VeresDenisa/Licenta/images/Design/LEDMANAGER.png

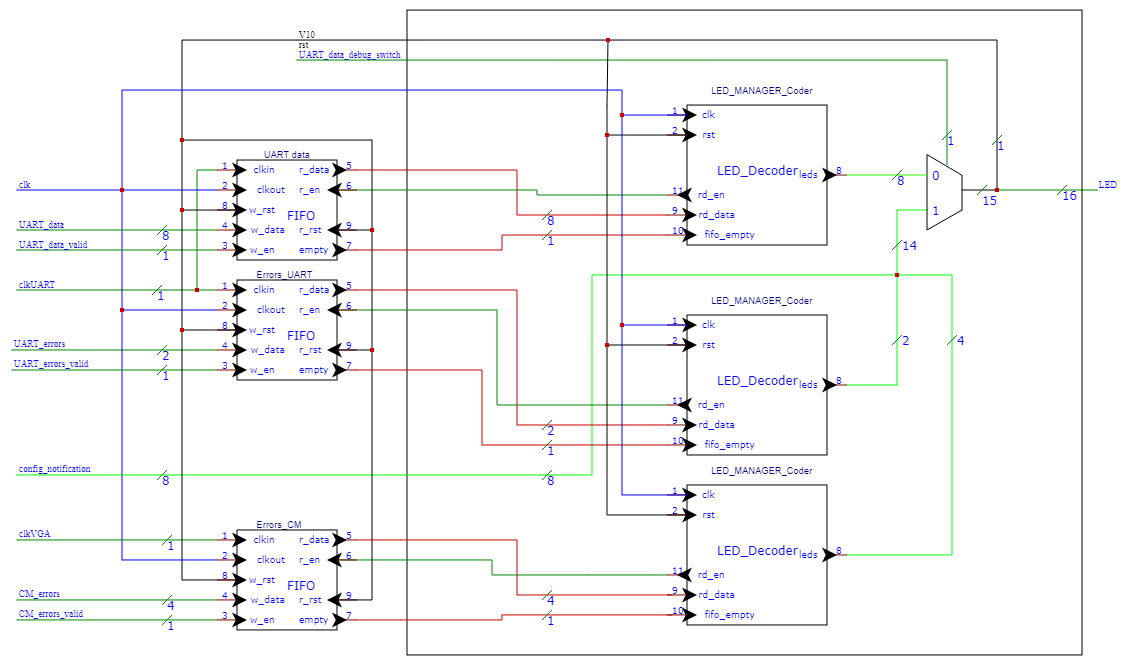
images/Design/LEDMANAGER.png
