VeresDenisa/Licenta/images/Design/project_final.png

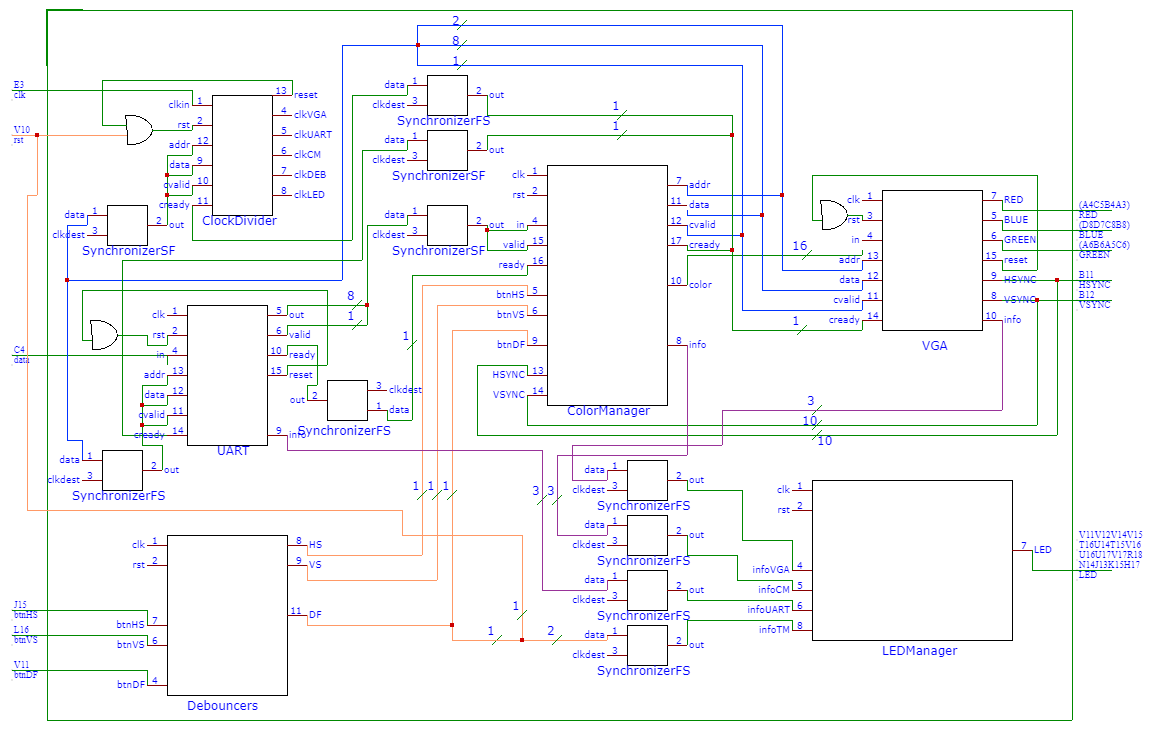
images/Design/project_final.png
