VeresDenisa/Licenta/source/simulation/coverage/coverage_CM_test.txt

COVERGROUP COVERAGE:
-----------------------------------------------------------------------------------------------
Covergroup                                             Metric       Goal    Status               
                                                                                              
-----------------------------------------------------------------------------------------------
 TYPE /CM_coverage_pack/CM_input_covergroup           100.00%        100    Covered              
    covered/total bins:                                    15         15                      
    missing/total bins:                                     0         15                      
    % Hit:                                            100.00%        100                      
    type_option.weight=1
    type_option.goal=100
    type_option.comment=
    type_option.strobe=0
    type_option.merge_instances=auto(0)
    Coverpoint CM_input_covergroup::HSync_cvp         100.00%        100    Covered              
        covered/total bins:                                 2          2                      
        missing/total bins:                                 0          2                      
        % Hit:                                        100.00%        100                      
        type_option.weight=1
        type_option.goal=100
        type_option.comment=
    Coverpoint CM_input_covergroup::VSync_cvp         100.00%        100    Covered              
        covered/total bins:                                 2          2                      
        missing/total bins:                                 0          2                      
        % Hit:                                        100.00%        100                      
        type_option.weight=1
        type_option.goal=100
        type_option.comment=
    Coverpoint CM_input_covergroup::Vertical_Split_cvp 
                                                      100.00%        100    Covered              
        covered/total bins:                                 2          2                      
        missing/total bins:                                 0          2                      
        % Hit:                                        100.00%        100                      
        type_option.weight=1
        type_option.goal=100
        type_option.comment=
    Coverpoint CM_input_covergroup::Horizontal_Split_cvp 
                                                      100.00%        100    Covered              
        covered/total bins:                                 2          2                      
        missing/total bins:                                 0          2                      
        % Hit:                                        100.00%        100                      
        type_option.weight=1
        type_option.goal=100
        type_option.comment=
    Coverpoint CM_input_covergroup::Empty_cvp         100.00%        100    Covered              
        covered/total bins:                                 2          2                      
        missing/total bins:                                 0          2                      
        % Hit:                                        100.00%        100                      
        type_option.weight=1
        type_option.goal=100
        type_option.comment=
    Coverpoint CM_input_covergroup::VGA_debug_cvp     100.00%        100    Covered              
        covered/total bins:                                 2          2                      
        missing/total bins:                                 0          2                      
        % Hit:                                        100.00%        100                      
        type_option.weight=1
        type_option.goal=100
        type_option.comment=
    Coverpoint CM_input_covergroup::RXD_Data_cvp      100.00%        100    Covered              
        covered/total bins:                                 3          3                      
        missing/total bins:                                 0          3                      
        % Hit:                                        100.00%        100                      
        type_option.weight=1
        type_option.goal=100
        type_option.comment=
 Covergroup instance \/CM_coverage_pack::CM_coverage::CM_input_cvg  
                                                      100.00%        100    Covered              
    covered/total bins:                                    15         15                      
    missing/total bins:                                     0         15                      
    % Hit:                                            100.00%        100                      
    option.name=\/CM_coverage_pack::CM_coverage::CM_input_cvg 
    option.weight=1
    option.goal=100
    option.comment=
    option.at_least=1
    option.auto_bin_max=64
    option.cross_num_print_missing=0
    option.detect_overlap=0
    option.per_instance=0
    option.get_inst_coverage=0
    Coverpoint HSync_cvp                              100.00%        100    Covered              
        covered/total bins:                                 2          2                      
        missing/total bins:                                 0          2                      
        % Hit:                                        100.00%        100                      
        option.weight=1
        option.goal=100
        option.comment=
        option.at_least=1
        option.auto_bin_max=64
        option.detect_overlap=0
        bin value_binary[0]                                59          1    Covered              
        bin value_binary[1]                                49          1    Covered              
    Coverpoint VSync_cvp                              100.00%        100    Covered              
        covered/total bins:                                 2          2                      
        missing/total bins:                                 0          2                      
        % Hit:                                        100.00%        100                      
        option.weight=1
        option.goal=100
        option.comment=
        option.at_least=1
        option.auto_bin_max=64
        option.detect_overlap=0
        bin value_binary[0]                                65          1    Covered              
        bin value_binary[1]                                43          1    Covered              
    Coverpoint Vertical_Split_cvp                     100.00%        100    Covered              
        covered/total bins:                                 2          2                      
        missing/total bins:                                 0          2                      
        % Hit:                                        100.00%        100                      
        option.weight=1
        option.goal=100
        option.comment=
        option.at_least=1
        option.auto_bin_max=64
        option.detect_overlap=0
        bin value_binary[0]                                59          1    Covered              
        bin value_binary[1]                                49          1    Covered              
    Coverpoint Horizontal_Split_cvp                   100.00%        100    Covered              
        covered/total bins:                                 2          2                      
        missing/total bins:                                 0          2                      
        % Hit:                                        100.00%        100                      
        option.weight=1
        option.goal=100
        option.comment=
        option.at_least=1
        option.auto_bin_max=64
        option.detect_overlap=0
        bin value_binary[0]                                59          1    Covered              
        bin value_binary[1]                                49          1    Covered              
    Coverpoint Empty_cvp                              100.00%        100    Covered              
        covered/total bins:                                 2          2                      
        missing/total bins:                                 0          2                      
        % Hit:                                        100.00%        100                      
        option.weight=1
        option.goal=100
        option.comment=
        option.at_least=1
        option.auto_bin_max=64
        option.detect_overlap=0
        bin value_binary[0]                                60          1    Covered              
        bin value_binary[1]                                48          1    Covered              
    Coverpoint VGA_debug_cvp                          100.00%        100    Covered              
        covered/total bins:                                 2          2                      
        missing/total bins:                                 0          2                      
        % Hit:                                        100.00%        100                      
        option.weight=1
        option.goal=100
        option.comment=
        option.at_least=1
        option.auto_bin_max=64
        option.detect_overlap=0
        bin value_binary[0]                                63          1    Covered              
        bin value_binary[1]                                45          1    Covered              
    Coverpoint RXD_Data_cvp                           100.00%        100    Covered              
        covered/total bins:                                 3          3                      
        missing/total bins:                                 0          3                      
        % Hit:                                        100.00%        100                      
        option.weight=1
        option.goal=100
        option.comment=
        option.at_least=1
        option.auto_bin_max=64
        option.detect_overlap=0
        bin inter_values[0]                                42          1    Covered              
        bin inter_values[1]                                31          1    Covered              
        bin inter_values[2]                                35          1    Covered              
 TYPE /CM_coverage_pack/CM_output_covergroup           76.56%        100    Uncovered            
    covered/total bins:                                     9         54                      
    missing/total bins:                                    45         54                      
    % Hit:                                             16.66%        100                      
    type_option.weight=1
    type_option.goal=100
    type_option.comment=
    type_option.strobe=0
    type_option.merge_instances=auto(0)
    Coverpoint CM_output_covergroup::Config_Notification_Valid_cvp 
                                                      100.00%        100    Covered              
        covered/total bins:                                 2          2                      
        missing/total bins:                                 0          2                      
        % Hit:                                        100.00%        100                      
        type_option.weight=1
        type_option.goal=100
        type_option.comment=
    Coverpoint CM_output_covergroup::VGA_Notification_Valid_cvp 
                                                      100.00%        100    Covered              
        covered/total bins:                                 2          2                      
        missing/total bins:                                 0          2                      
        % Hit:                                        100.00%        100                      
        type_option.weight=1
        type_option.goal=100
        type_option.comment=
    Coverpoint CM_output_covergroup::Error_Valid_cvp 
                                                      100.00%        100    Covered              
        covered/total bins:                                 2          2                      
        missing/total bins:                                 0          2                      
        % Hit:                                        100.00%        100                      
        type_option.weight=1
        type_option.goal=100
        type_option.comment=
    Coverpoint CM_output_covergroup::Data_VGA_cvp       6.25%        100    Uncovered            
        covered/total bins:                                 3         48                      
        missing/total bins:                                45         48                      
        % Hit:                                          6.25%        100                      
        type_option.weight=1
        type_option.goal=100
        type_option.comment=
 Covergroup instance \/CM_coverage_pack::CM_coverage::CM_output_cvg  
                                                       76.56%        100    Uncovered            
    covered/total bins:                                     9         54                      
    missing/total bins:                                    45         54                      
    % Hit:                                             16.66%        100                      
    option.name=\/CM_coverage_pack::CM_coverage::CM_output_cvg 
    option.weight=1
    option.goal=100
    option.comment=
    option.at_least=1
    option.auto_bin_max=64
    option.cross_num_print_missing=0
    option.detect_overlap=0
    option.per_instance=0
    option.get_inst_coverage=0
    Coverpoint Config_Notification_Valid_cvp          100.00%        100    Covered              
        covered/total bins:                                 2          2                      
        missing/total bins:                                 0          2                      
        % Hit:                                        100.00%        100                      
        option.weight=1
        option.goal=100
        option.comment=
        option.at_least=1
        option.auto_bin_max=64
        option.detect_overlap=0
        bin value_binary[0]                               106          1    Covered              
        bin value_binary[1]                                 6          1    Covered              
    Coverpoint VGA_Notification_Valid_cvp             100.00%        100    Covered              
        covered/total bins:                                 2          2                      
        missing/total bins:                                 0          2                      
        % Hit:                                        100.00%        100                      
        option.weight=1
        option.goal=100
        option.comment=
        option.at_least=1
        option.auto_bin_max=64
        option.detect_overlap=0
        bin value_binary[0]                                71          1    Covered              
        bin value_binary[1]                                41          1    Covered              
    Coverpoint Error_Valid_cvp                        100.00%        100    Covered              
        covered/total bins:                                 2          2                      
        missing/total bins:                                 0          2                      
        % Hit:                                        100.00%        100                      
        option.weight=1
        option.goal=100
        option.comment=
        option.at_least=1
        option.auto_bin_max=64
        option.detect_overlap=0
        bin value_binary[0]                               102          1    Covered              
        bin value_binary[1]                                10          1    Covered              
    Coverpoint Data_VGA_cvp                             6.25%        100    Uncovered            
        covered/total bins:                                 3         48                      
        missing/total bins:                                45         48                      
        % Hit:                                          6.25%        100                      
        option.weight=1
        option.goal=100
        option.comment=
        option.at_least=1
        option.auto_bin_max=64
        option.detect_overlap=0
        bin values05[0]                                   112          1    Covered              
        bin values05[1]                                     0          1    ZERO                 
        bin values05[2]                                     0          1    ZERO                 
        bin values05[3]                                     0          1    ZERO                 
        bin values05[4]                                     0          1    ZERO                 
        bin values05[5]                                     0          1    ZERO                 
        bin values05[6]                                     0          1    ZERO                 
        bin values05[7]                                     0          1    ZERO                 
        bin values0A[0]                                   112          1    Covered              
        bin values0A[1]                                     0          1    ZERO                 
        bin values0A[2]                                     0          1    ZERO                 
        bin values0A[3]                                     0          1    ZERO                 
        bin values0A[4]                                     0          1    ZERO                 
        bin values0A[5]                                     0          1    ZERO                 
        bin values0A[6]                                     0          1    ZERO                 
        bin values0A[7]                                     0          1    ZERO                 
        bin values0F[0]                                   112          1    Covered              
        bin values0F[1]                                     0          1    ZERO                 
        bin values0F[2]                                     0          1    ZERO                 
        bin values0F[3]                                     0          1    ZERO                 
        bin values0F[4]                                     0          1    ZERO                 
        bin values0F[5]                                     0          1    ZERO                 
        bin values0F[6]                                     0          1    ZERO                 
        bin values0F[7]                                     0          1    ZERO                 
        bin values5A[0]                                     0          1    ZERO                 
        bin values5A[1]                                     0          1    ZERO                 
        bin values5A[2]                                     0          1    ZERO                 
        bin values5A[3]                                     0          1    ZERO                 
        bin values5A[4]                                     0          1    ZERO                 
        bin values5A[5]                                     0          1    ZERO                 
        bin values5A[6]                                     0          1    ZERO                 
        bin values5A[7]                                     0          1    ZERO                 
        bin values5F[0]                                     0          1    ZERO                 
        bin values5F[1]                                     0          1    ZERO                 
        bin values5F[2]                                     0          1    ZERO                 
        bin values5F[3]                                     0          1    ZERO                 
        bin values5F[4]                                     0          1    ZERO                 
        bin values5F[5]                                     0          1    ZERO                 
        bin values5F[6]                                     0          1    ZERO                 
        bin values5F[7]                                     0          1    ZERO                 
        bin valuesAF[0]                                     0          1    ZERO                 
        bin valuesAF[1]                                     0          1    ZERO                 
        bin valuesAF[2]                                     0          1    ZERO                 
        bin valuesAF[3]                                     0          1    ZERO                 
        bin valuesAF[4]                                     0          1    ZERO                 
        bin valuesAF[5]                                     0          1    ZERO                 
        bin valuesAF[6]                                     0          1    ZERO                 
        bin valuesAF[7]                                     0          1    ZERO                 

TOTAL COVERGROUP COVERAGE: 88.28%  COVERGROUP TYPES: 2
