VeresDenisa/Licenta/source/simulation/coverage/coverage_LM_test.txt

COVERGROUP COVERAGE:
-----------------------------------------------------------------------------------------------
Covergroup                                             Metric       Goal    Status               
                                                                                              
-----------------------------------------------------------------------------------------------
 TYPE /LM_coverage_pack/CM_output_covergroup          100.00%        100    Covered              
    covered/total bins:                                     6         54                      
    missing/total bins:                                    48         54                      
    % Hit:                                             11.11%        100                      
    type_option.weight=1
    type_option.goal=100
    type_option.comment=
    type_option.strobe=0
    type_option.merge_instances=auto(0)
    Coverpoint CM_output_covergroup::Config_Notification_Valid_cvp 
                                                      100.00%        100    Covered              
        covered/total bins:                                 2          2                      
        missing/total bins:                                 0          2                      
        % Hit:                                        100.00%        100                      
        type_option.weight=1
        type_option.goal=100
        type_option.comment=
    Coverpoint CM_output_covergroup::VGA_Notification_Valid_cvp 
                                                      100.00%        100    Covered              
        covered/total bins:                                 2          2                      
        missing/total bins:                                 0          2                      
        % Hit:                                        100.00%        100                      
        type_option.weight=1
        type_option.goal=100
        type_option.comment=
    Coverpoint CM_output_covergroup::Error_Valid_cvp 
                                                      100.00%        100    Covered              
        covered/total bins:                                 2          2                      
        missing/total bins:                                 0          2                      
        % Hit:                                        100.00%        100                      
        type_option.weight=1
        type_option.goal=100
        type_option.comment=
    Coverpoint CM_output_covergroup::Data_VGA_cvp       0.00%        100    ZERO                 
        covered/total bins:                                 0          0                      
        missing/total bins:                                 0          0                      
        % Hit:                                        100.00%        100                      
        type_option.weight=1
        type_option.goal=100
        type_option.comment=
 Covergroup instance \/LM_coverage_pack::LM_coverage::CM_output_cvg  
                                                      100.00%        100    Covered              
    covered/total bins:                                     6         54                      
    missing/total bins:                                    48         54                      
    % Hit:                                             11.11%        100                      
    option.name=\/LM_coverage_pack::LM_coverage::CM_output_cvg 
    option.weight=1
    option.goal=100
    option.comment=
    option.at_least=1
    option.auto_bin_max=64
    option.cross_num_print_missing=0
    option.detect_overlap=0
    option.per_instance=0
    option.get_inst_coverage=0
    Coverpoint Config_Notification_Valid_cvp          100.00%        100    Covered              
        covered/total bins:                                 2          2                      
        missing/total bins:                                 0          2                      
        % Hit:                                        100.00%        100                      
        option.weight=1
        option.goal=100
        option.comment=
        option.at_least=1
        option.auto_bin_max=64
        option.detect_overlap=0
        bin value_binary[0]                                82          1    Covered              
        bin value_binary[1]                                66          1    Covered              
    Coverpoint VGA_Notification_Valid_cvp             100.00%        100    Covered              
        covered/total bins:                                 2          2                      
        missing/total bins:                                 0          2                      
        % Hit:                                        100.00%        100                      
        option.weight=1
        option.goal=100
        option.comment=
        option.at_least=1
        option.auto_bin_max=64
        option.detect_overlap=0
        bin value_binary[0]                                73          1    Covered              
        bin value_binary[1]                                75          1    Covered              
    Coverpoint Error_Valid_cvp                        100.00%        100    Covered              
        covered/total bins:                                 2          2                      
        missing/total bins:                                 0          2                      
        % Hit:                                        100.00%        100                      
        option.weight=1
        option.goal=100
        option.comment=
        option.at_least=1
        option.auto_bin_max=64
        option.detect_overlap=0
        bin value_binary[0]                                68          1    Covered              
        bin value_binary[1]                                80          1    Covered              
    Coverpoint Data_VGA_cvp [1]                         0.00%        100    ZERO                 
        covered/total bins:                                 0         48                      
        missing/total bins:                                48         48                      
        % Hit:                                          0.00%        100                      
        option.weight=0
        option.goal=100
        option.comment=
        option.at_least=1
        option.auto_bin_max=64
        option.detect_overlap=0
        bin values05[0]                                     0          1    ZERO                 
        bin values05[1]                                     0          1    ZERO                 
        bin values05[2]                                     0          1    ZERO                 
        bin values05[3]                                     0          1    ZERO                 
        bin values05[4]                                     0          1    ZERO                 
        bin values05[5]                                     0          1    ZERO                 
        bin values05[6]                                     0          1    ZERO                 
        bin values05[7]                                     0          1    ZERO                 
        bin values0A[0]                                     0          1    ZERO                 
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
    Coverpoint LM_covergroup::leds6_cvp               100.00%        100    Covered              
        covered/total bins:                                 2          2                      
        missing/total bins:                                 0          2                      
        % Hit:                                        100.00%        100                      
        type_option.weight=1
        type_option.goal=100
        type_option.comment=
    Coverpoint LM_covergroup::leds7_cvp               100.00%        100    Covered              
        covered/total bins:                                 2          2                      
        missing/total bins:                                 0          2                      
        % Hit:                                        100.00%        100                      
        type_option.weight=1
        type_option.goal=100
        type_option.comment=
 Covergroup instance \/LM_coverage_pack::LM_coverage::LM_cvg  
                                                      100.00%        100    Covered              
    covered/total bins:                                    16         16                      
    missing/total bins:                                     0         16                      
    % Hit:                                            100.00%        100                      
    option.name=\/LM_coverage_pack::LM_coverage::LM_cvg 
    option.weight=1
    option.goal=100
    option.comment=
    option.at_least=1
    option.auto_bin_max=64
    option.cross_num_print_missing=0
    option.detect_overlap=0
    option.per_instance=0
    option.get_inst_coverage=0
    Coverpoint leds0_cvp                              100.00%        100    Covered              
        covered/total bins:                                 2          2                      
        missing/total bins:                                 0          2                      
        % Hit:                                        100.00%        100                      
        option.weight=1
        option.goal=100
        option.comment=
        option.at_least=1
        option.auto_bin_max=64
        option.detect_overlap=0
        bin value_binary[0]                                87          1    Covered              
        bin value_binary[1]                                41          1    Covered              
    Coverpoint leds1_cvp                              100.00%        100    Covered              
        covered/total bins:                                 2          2                      
        missing/total bins:                                 0          2                      
        % Hit:                                        100.00%        100                      
        option.weight=1
        option.goal=100
        option.comment=
        option.at_least=1
        option.auto_bin_max=64
        option.detect_overlap=0
        bin value_binary[0]                                87          1    Covered              
        bin value_binary[1]                                41          1    Covered              
    Coverpoint leds2_cvp                              100.00%        100    Covered              
        covered/total bins:                                 2          2                      
        missing/total bins:                                 0          2                      
        % Hit:                                        100.00%        100                      
        option.weight=1
        option.goal=100
        option.comment=
        option.at_least=1
        option.auto_bin_max=64
        option.detect_overlap=0
        bin value_binary[0]                                91          1    Covered              
        bin value_binary[1]                                37          1    Covered              
    Coverpoint leds3_cvp                              100.00%        100    Covered              
        covered/total bins:                                 2          2                      
        missing/total bins:                                 0          2                      
        % Hit:                                        100.00%        100                      
        option.weight=1
        option.goal=100
        option.comment=
        option.at_least=1
        option.auto_bin_max=64
        option.detect_overlap=0
        bin value_binary[0]                                96          1    Covered              
        bin value_binary[1]                                32          1    Covered              
    Coverpoint leds4_cvp                              100.00%        100    Covered              
        covered/total bins:                                 2          2                      
        missing/total bins:                                 0          2                      
        % Hit:                                        100.00%        100                      
        option.weight=1
        option.goal=100
        option.comment=
        option.at_least=1
        option.auto_bin_max=64
        option.detect_overlap=0
        bin value_binary[0]                                89          1    Covered              
        bin value_binary[1]                                39          1    Covered              
    Coverpoint leds5_cvp                              100.00%        100    Covered              
        covered/total bins:                                 2          2                      
        missing/total bins:                                 0          2                      
        % Hit:                                        100.00%        100                      
        option.weight=1
        option.goal=100
        option.comment=
        option.at_least=1
        option.auto_bin_max=64
        option.detect_overlap=0
        bin value_binary[0]                                84          1    Covered              
        bin value_binary[1]                                44          1    Covered              
    Coverpoint leds6_cvp                              100.00%        100    Covered              
        covered/total bins:                                 2          2                      
        missing/total bins:                                 0          2                      
        % Hit:                                        100.00%        100                      
        option.weight=1
        option.goal=100
        option.comment=
        option.at_least=1
        option.auto_bin_max=64
        option.detect_overlap=0
        bin value_binary[0]                                42          1    Covered              
        bin value_binary[1]                                87          1    Covered              
    Coverpoint leds7_cvp                              100.00%        100    Covered              
        covered/total bins:                                 2          2                      
        missing/total bins:                                 0          2                      
        % Hit:                                        100.00%        100                      
        option.weight=1
        option.goal=100
        option.comment=
        option.at_least=1
        option.auto_bin_max=64
        option.detect_overlap=0
        bin value_binary[0]                               116          1    Covered              
        bin value_binary[1]                                13          1    Covered              
 TYPE /LM_coverage_pack/UART_covergroup                80.95%        100    Uncovered            
    covered/total bins:                                    14         22                      
    missing/total bins:                                     8         22                      
    % Hit:                                             63.63%        100                      
    type_option.weight=1
    type_option.goal=100
    type_option.comment=
    type_option.strobe=0
    type_option.merge_instances=auto(0)
    Coverpoint UART_covergroup::error_cvp             100.00%        100    Covered              
        covered/total bins:                                 3          3                      
        missing/total bins:                                 0          3                      
        % Hit:                                        100.00%        100                      
        type_option.weight=1
        type_option.goal=100
        type_option.comment=
    Coverpoint UART_covergroup::out_cvp                42.85%        100    Uncovered            
        covered/total bins:                                 3          7                      
        missing/total bins:                                 4          7                      
        % Hit:                                         42.85%        100                      
        type_option.weight=1
        type_option.goal=100
        type_option.comment=
    Coverpoint UART_covergroup::valid_error_cvp       100.00%        100    Covered              
        covered/total bins:                                 1          1                      
        missing/total bins:                                 0          1                      
        % Hit:                                        100.00%        100                      
        type_option.weight=1
        type_option.goal=100
        type_option.comment=
    Coverpoint UART_covergroup::valid_out_cvp         100.00%        100    Covered              
        covered/total bins:                                 1          1                      
        missing/total bins:                                 0          1                      
        % Hit:                                        100.00%        100                      
        type_option.weight=1
        type_option.goal=100
        type_option.comment=
    Cross UART_covergroup::data_cross                 100.00%        100    Covered              
        covered/total bins:                                 3          3                      
        missing/total bins:                                 0          3                      
        % Hit:                                        100.00%        100                      
        type_option.weight=1
        type_option.goal=100
        type_option.comment=
    Cross UART_covergroup::error_cross                 42.85%        100    Uncovered            
        covered/total bins:                                 3          7                      
        missing/total bins:                                 4          7                      
        % Hit:                                         42.85%        100                      
        type_option.weight=1
        type_option.goal=100
        type_option.comment=
 Covergroup instance \/LM_coverage_pack::LM_coverage::UART_cvg  
                                                       80.95%        100    Uncovered            
    covered/total bins:                                    14         22                      
    missing/total bins:                                     8         22                      
    % Hit:                                             63.63%        100                      
    option.name=\/LM_coverage_pack::LM_coverage::UART_cvg 
    option.weight=1
    option.goal=100
    option.comment=
    option.at_least=1
    option.auto_bin_max=64
    option.cross_num_print_missing=0
    option.detect_overlap=0
    option.per_instance=0
    option.get_inst_coverage=0
    Coverpoint error_cvp                              100.00%        100    Covered              
        covered/total bins:                                 3          3                      
        missing/total bins:                                 0          3                      
        % Hit:                                        100.00%        100                      
        option.weight=1
        option.goal=100
        option.comment=
        option.at_least=1
        option.auto_bin_max=64
        option.detect_overlap=0
        bin values[0]                                      37          1    Covered              
        bin values[1]                                      31          1    Covered              
        bin values[2]                                      31          1    Covered              
    Coverpoint out_cvp                                 42.85%        100    Uncovered            
        covered/total bins:                                 3          7                      
        missing/total bins:                                 4          7                      
        % Hit:                                         42.85%        100                      
        option.weight=1
        option.goal=100
        option.comment=
        option.at_least=1
        option.auto_bin_max=64
        option.detect_overlap=0
        bin limit_values[0]                                 0          1    ZERO                 
        bin limit_values[1]                                 0          1    ZERO                 
        bin limit_values[2]                                 0          1    ZERO                 
        bin limit_values[3]                                 0          1    ZERO                 
        bin inter_values[0]                                59          1    Covered              
        bin inter_values[1]                                44          1    Covered              
        bin inter_values[2]                                45          1    Covered              
    Coverpoint valid_error_cvp                        100.00%        100    Covered              
        covered/total bins:                                 1          1                      
        missing/total bins:                                 0          1                      
        % Hit:                                        100.00%        100                      
        option.weight=1
        option.goal=100
        option.comment=
        option.at_least=1
        option.auto_bin_max=64
        option.detect_overlap=0
        bin value_binary[0]                                76          1    Covered              
    Coverpoint valid_out_cvp                          100.00%        100    Covered              
        covered/total bins:                                 1          1                      
        missing/total bins:                                 0          1                      
        % Hit:                                        100.00%        100                      
        option.weight=1
        option.goal=100
        option.comment=
        option.at_least=1
        option.auto_bin_max=64
        option.detect_overlap=0
        bin value_binary[0]                                71          1    Covered              
    Cross data_cross                                  100.00%        100    Covered              
        covered/total bins:                                 3          3                      
        missing/total bins:                                 0          3                      
        % Hit:                                        100.00%        100                      
        option.weight=1
        option.goal=100
        option.comment=
        option.at_least=1
        option.cross_num_print_missing=0
        bin <values[0],value_binary[0]>                    14          1    Covered              
        bin <values[1],value_binary[0]>                    18          1    Covered              
        bin <values[2],value_binary[0]>                    19          1    Covered              
    Cross error_cross                                  42.85%        100    Uncovered            
        covered/total bins:                                 3          7                      
        missing/total bins:                                 4          7                      
        % Hit:                                         42.85%        100                      
        option.weight=1
        option.goal=100
        option.comment=
        option.at_least=1
        option.cross_num_print_missing=0
        bin <inter_values[0],value_binary[0]>              25          1    Covered              
        bin <inter_values[1],value_binary[0]>              22          1    Covered              
        bin <inter_values[2],value_binary[0]>              24          1    Covered              
        bin <limit_values[0],value_binary[0]>               0          1    ZERO                 
        bin <limit_values[1],value_binary[0]>               0          1    ZERO                 
        bin <limit_values[2],value_binary[0]>               0          1    ZERO                 
        bin <limit_values[3],value_binary[0]>               0          1    ZERO                 

 [1] - Does not contribute coverage as weight is 0

TOTAL COVERGROUP COVERAGE: 93.65%  COVERGROUP TYPES: 3
