VeresDenisa/Licenta/diamond/CS_implementation/source/CLK_values.v

parameter CLK_BAUDRATE_2400 = 10;
parameter CLK_BAUDRATE_4800 = 20;
parameter CLK_BAUDRATE_9600 = 40;
parameter CLK_BAUDRATE_19200 = 80;
parameter CLK_BAUDRATE_57600 = 240;
parameter CLK_BAUDRATE_112000 = 480;

parameter CLK_VGA_640x480 = 3;
parameter CLK_VGA_800x600 = 2;
parameter CLK_VGA_1024x768 = 1;

parameter CLK_DEBOUNCER = 32'd90;
parameter CLK_LED_MANAGER = 32'd265;
 

/*
parameter CLK_BAUDRATE_2400 = 26042;
parameter CLK_BAUDRATE_4800 = 13021;
parameter CLK_BAUDRATE_9600 = 6510;
parameter CLK_BAUDRATE_19200 = 3255;
parameter CLK_BAUDRATE_57600 = 1085;
parameter CLK_BAUDRATE_11200 = 543;

parameter CLK_VGA_640x480 = 40;
parameter CLK_VGA_800x600 = 25;
parameter CLK_VGA_1024x768 = 15;

parameter CLK_DEBOUNCER = 50000;
parameter CLK_LED_MANAGER = 1000000000;
*/
