VeresDenisa/Licenta/source/testbench/pack/UART_sequence_pack.sv

package UART_sequence_pack;
    import uvm_pkg::*;
    `include "uvm_macros.svh"
  
    import item_pack::*;
  
    `include "testbench/CONF/test/sequence/CONF_input_sequence.svh"

    `include "testbench/UART/test/sequence/UART_input_sequence.svh"
  endpackage : UART_sequence_pack
