VeresDenisa/Licenta/diamond/CS_implementation/source/CM_Width_Parameters.v

parameter UART_DATA_WIDTH =8,
parameter WORD_WIDTH =16,
parameter c_addr_WIDTH = 4,
parameter c_data_WIDTH = 14,
parameter CONFIG_NOTIFICATION_WIDTH = 4,
parameter CONFIG_STATUS_WIDTH = 8,
parameter CONFIG_ERROR_WIDTH = 4,
parameter STATE_WIDTH =3,

parameter COUNTER_WIDTH = 10,
parameter VGA_NOTIFICATION_WIDTH = 4,
parameter DATA_WIDTH = 12, 
parameter BACKPORCH_WIDTH=8,
parameter FRONTPORCH_WIDTH=10,
parameter QUADRAN_WIDTH = 2,
parameter c_data_CONFIG_WIDTH = 2,

//Parameters for repetition
parameter CONFIG_BOUDRATE_WIDTH 	= 3,
parameter CONFIG_PARITY_WIDTH		= 2,
parameter CONFIG_REZOLUTION_WIDTH 	= 2,
parameter CONFIG_QUADRAN_WIDTH 		= 2
