VeresDenisa/Licenta/source/testbench/LM/interface/LM_VIF.sv

import item_pack::*;

interface LM_VIF(input bit clk);
    logic [7:0] leds;

    clocking monitor@(posedge clk);
        input leds;
    endclocking

    function automatic void receive(ref LM_item t);
        t.leds  = monitor.leds;
    endfunction
endinterface : LM_VIF
