VeresDenisa/Licenta/source/testbench/pack/CM_sequence_pack.sv

package CM_sequence_pack;
    import uvm_pkg::*;
    `include "uvm_macros.svh"
  
    import item_pack::*;
  
    `include "testbench/CM/test/sequence/CM_input_sequence.svh"
    `include "testbench/CM/test/sequence/CM_output_sequence.svh"

    `include "testbench/CONF/test/sequence/CONF_output_sequence.svh"
  endpackage : CM_sequence_pack
