VeresDenisa/Licenta/diamond/CS_implementation/source/CS_errors.v

parameter NO_ERRORS = 'd0;

//UART
parameter FAILED_STOP_BITS = 2'b11;
parameter FAILED_PARITY_BIT = 2'b01;
parameter FAILED_IDLE_BITS = 2'b10;

//ColorManager
parameter FAILED_CONFIGURATION_ADDRESS = 4'b0011;

parameter FAILED_BAUDRATE_CONFIGURATION = 4'b0100;
parameter FAILED_PARITYBIT_CONFIGURATION = 4'b0101; 
parameter FAILED_STOPBITS_CONFIGURATION = 4'b0110;
parameter FAILED_RESOLUTION_CONFIGURATION = 4'b0111;

parameter CORRECT_BAUDRATE_CONFIGURATION = 4'b1100;
parameter CORRECT_PARITYBIT_CONFIGURATION = 4'b1101;
parameter CORRECT_STOPBITS_CONFIGURATION = 4'b1110;
parameter CORRECT_RESOLUTION_CONFIGURATION = 4'b1111;

parameter WRONG_QUADRANT = 4'b0010;

parameter QUADRANT_1_CHANGE = 4'b1000;
parameter QUADRANT_2_CHANGE = 4'b1001;
parameter QUADRANT_3_CHANGE = 4'b1010;
parameter QUADRANT_4_CHANGE = 4'b1011;
