VeresDenisa/Licenta/diamond/CS_implementation/source/VGA_Parameters.v

//Parameters are taken from https://web.mit.edu/6.111/www/s2004/NEWKIT/vga.shtml, for the 60Hz
//____________+------------------------------------------+
//pulse_width |back porch   | active zone   | front porch|
	
	//Parameters for left margin, where left margin means back porch + sync pulse
	parameter [VL_MARGIN_WIDTH-1:0] V_Left_Margin_RD      =  6'b100001,   //31+2=33
	parameter [VL_MARGIN_WIDTH-1:0] V_Left_Margin_R8x6    =  6'b011011,   //23+4=27
    parameter [VL_MARGIN_WIDTH-1:0] V_Left_Margin_R10x7   =  6'b100011,   //29+6=35
	 
	parameter [HL_MARGIN_WIDTH-1:0] H_Left_Margin_RD      =  9'b010010000,   // 48+ 96=144
    parameter [HL_MARGIN_WIDTH-1:0] H_Left_Margin_R8x6    =  9'b011010100,   // 88+128=212
    parameter [HL_MARGIN_WIDTH-1:0] H_Left_Margin_R10x7   =  9'b100101000,   //160+136=296

	
	//Parameters for right margin, where right margin means maximum counters - front porch (or sync pulse + back porch + acive) 
	parameter [VR_MARGIN_WIDTH-1:0] V_Right_Margin_RD     =  10'b1000000001,    //524-11=513
	parameter [VR_MARGIN_WIDTH-1:0] V_Right_Margin_R8x6   =  10'b1001110011,	//628- 1=627
    parameter [VR_MARGIN_WIDTH-1:0] V_Right_Margin_R10x7  =  10'b1100100011,   // 806- 3=803

	parameter [HR_MARGIN_WIDTH-1:0] H_Right_Margin_RD     =  11'b01100010000,   // 800-16= 784
    parameter [HR_MARGIN_WIDTH-1:0] H_Right_Margin_R8x6   =  11'b01111111000,   //1056-40=1016
    parameter [HR_MARGIN_WIDTH-1:0] H_Right_Margin_R10x7  =  11'b10100101000,   //1344-24=1320

	
	//Parameters for sync pulse, where the actual parameter is the sync pulse - 2
	parameter [PULSE_WIDTH-1:0] H_Sync_Pulse_RD    =  8'b01011110,  // 96-2=94
	parameter [PULSE_WIDTH-1:0] V_Sync_Pulse_RD    =  8'b00000000,  //  2-2=0
	parameter [PULSE_WIDTH-1:0] H_Sync_Pulse_R8x6  =  8'b01111110,  //128-2=126
    parameter [PULSE_WIDTH-1:0] V_Sync_Pulse_R8x6  =  8'b00000010,  //  4-2=2
	parameter [PULSE_WIDTH-1:0] H_Sync_Pulse_R10x7 =  8'b10000110,  //136-2=134
	parameter [PULSE_WIDTH-1:0] V_Sync_Pulse_R10x7 =  8'b00000100,  //  6-2=4
	
	// Parameters for maximum counters, where maximum is the sum of the active+front porch + back porch + sync pulse
    parameter [REZ_MAX_WIDTH-1:0] V_Count_Max_RD    =  12'b001000001100,   // 480+11+  2+ 31= 524
    parameter [REZ_MAX_WIDTH-1:0] H_Count_Max_RD    =  12'b001100100000,   // 640+16+ 96+ 48= 800
    parameter [REZ_MAX_WIDTH-1:0] V_Count_Max_R8x6  =  12'b001001110100,   // 600+ 1+  4+ 23= 628
    parameter [REZ_MAX_WIDTH-1:0] H_Count_Max_R8x6  =  12'b010000100000,   // 800+40+128+ 88=1056
	parameter [REZ_MAX_WIDTH-1:0] V_Count_Max_R10x7 =  12'b001100100110,   // 768+ 3+  6+ 29= 806
    parameter [REZ_MAX_WIDTH-1:0] H_Count_Max_R10x7 =  12'b101010000000    //1024+24+136+160=1344
