VeresDenisa/Licenta/diamond/CS_implementation/source/VGA_Width_Parameters.v

parameter CONFIG_WIDTH  	=  2,
parameter COLOR_WIDTH   	=  4,
parameter VL_MARGIN_WIDTH 	=  6,
parameter PULSE_WIDTH   	=  8,
parameter HL_MARGIN_WIDTH 	=  9,
parameter VR_MARGIN_WIDTH 	= 10,
parameter HR_MARGIN_WIDTH 	= 11,
parameter REZ_MAX_WIDTH 	= 12,
parameter DATA_WIDTH    	= 12

 
