VeresDenisa/Licenta/source/simulation/coverage/coverage_UART_test_no_config.txt

COVERGROUP COVERAGE:
-----------------------------------------------------------------------------------------------
Covergroup                                             Metric       Goal    Status               
                                                                                              
-----------------------------------------------------------------------------------------------
 TYPE /UART_coverage_pack/UART_covergroup              50.79%        100    Uncovered            
    covered/total bins:                                    14         22                      
    missing/total bins:                                     8         22                      
    % Hit:                                             63.63%        100                      
    type_option.weight=1
    type_option.goal=100
    type_option.comment=
    type_option.strobe=0
    type_option.merge_instances=auto(0)
    Coverpoint UART_covergroup::error_cvp              33.33%        100    Uncovered            
        covered/total bins:                                 1          3                      
        missing/total bins:                                 2          3                      
        % Hit:                                         33.33%        100                      
        type_option.weight=1
        type_option.goal=100
        type_option.comment=
    Coverpoint UART_covergroup::out_cvp               100.00%        100    Covered              
        covered/total bins:                                 7          7                      
        missing/total bins:                                 0          7                      
        % Hit:                                        100.00%        100                      
        type_option.weight=1
        type_option.goal=100
        type_option.comment=
    Coverpoint UART_covergroup::valid_error_cvp         0.00%        100    ZERO                 
        covered/total bins:                                 0          1                      
        missing/total bins:                                 1          1                      
        % Hit:                                          0.00%        100                      
        type_option.weight=1
        type_option.goal=100
        type_option.comment=
    Coverpoint UART_covergroup::valid_out_cvp         100.00%        100    Covered              
        covered/total bins:                                 1          1                      
        missing/total bins:                                 0          1                      
        % Hit:                                        100.00%        100                      
        type_option.weight=1
        type_option.goal=100
        type_option.comment=
    Cross UART_covergroup::data_cross                   0.00%        100    ZERO                 
        covered/total bins:                                 0          3                      
        missing/total bins:                                 3          3                      
        % Hit:                                          0.00%        100                      
        type_option.weight=1
        type_option.goal=100
        type_option.comment=
    Cross UART_covergroup::error_cross                 71.42%        100    Uncovered            
        covered/total bins:                                 5          7                      
        missing/total bins:                                 2          7                      
        % Hit:                                         71.42%        100                      
        type_option.weight=1
        type_option.goal=100
        type_option.comment=
 Covergroup instance \/UART_coverage_pack::UART_coverage::UART_cvg  
                                                       50.79%        100    Uncovered            
    covered/total bins:                                    14         22                      
    missing/total bins:                                     8         22                      
    % Hit:                                             63.63%        100                      
    option.name=\/UART_coverage_pack::UART_coverage::UART_cvg 
    option.weight=1
    option.goal=100
    option.comment=
    option.at_least=1
    option.auto_bin_max=64
    option.cross_num_print_missing=0
    option.detect_overlap=0
    option.per_instance=0
    option.get_inst_coverage=0
    Coverpoint error_cvp                               33.33%        100    Uncovered            
        covered/total bins:                                 1          3                      
        missing/total bins:                                 2          3                      
        % Hit:                                         33.33%        100                      
        option.weight=1
        option.goal=100
        option.comment=
        option.at_least=1
        option.auto_bin_max=64
        option.detect_overlap=0
        bin values[0]                                    9686          1    Covered              
        bin values[1]                                       0          1    ZERO                 
        bin values[2]                                       0          1    ZERO                 
    Coverpoint out_cvp                                100.00%        100    Covered              
        covered/total bins:                                 7          7                      
        missing/total bins:                                 0          7                      
        % Hit:                                        100.00%        100                      
        option.weight=1
        option.goal=100
        option.comment=
        option.at_least=1
        option.auto_bin_max=64
        option.detect_overlap=0
        bin limit_values[0]                                49          1    Covered              
        bin limit_values[1]                                16          1    Covered              
        bin limit_values[2]                                97          1    Covered              
        bin limit_values[3]                                97          1    Covered              
        bin inter_values[0]                              6311          1    Covered              
        bin inter_values[1]                              1710          1    Covered              
        bin inter_values[2]                              1455          1    Covered              
    Coverpoint valid_error_cvp                          0.00%        100    ZERO                 
        covered/total bins:                                 0          1                      
        missing/total bins:                                 1          1                      
        % Hit:                                          0.00%        100                      
        option.weight=1
        option.goal=100
        option.comment=
        option.at_least=1
        option.auto_bin_max=64
        option.detect_overlap=0
        bin value_binary[0]                                 0          1    ZERO                 
    Coverpoint valid_out_cvp                          100.00%        100    Covered              
        covered/total bins:                                 1          1                      
        missing/total bins:                                 0          1                      
        % Hit:                                        100.00%        100                      
        option.weight=1
        option.goal=100
        option.comment=
        option.at_least=1
        option.auto_bin_max=64
        option.detect_overlap=0
        bin value_binary[0]                                50          1    Covered              
    Cross data_cross                                    0.00%        100    ZERO                 
        covered/total bins:                                 0          3                      
        missing/total bins:                                 3          3                      
        % Hit:                                          0.00%        100                      
        option.weight=1
        option.goal=100
        option.comment=
        option.at_least=1
        option.cross_num_print_missing=0
        bin <values[0],value_binary[0]>                     0          1    ZERO                 
        bin <values[1],value_binary[0]>                     0          1    ZERO                 
        bin <values[2],value_binary[0]>                     0          1    ZERO                 
    Cross error_cross                                  71.42%        100    Uncovered            
        covered/total bins:                                 5          7                      
        missing/total bins:                                 2          7                      
        % Hit:                                         71.42%        100                      
        option.weight=1
        option.goal=100
        option.comment=
        option.at_least=1
        option.cross_num_print_missing=0
        bin <limit_values[2],value_binary[0]>               1          1    Covered              
        bin <limit_values[3],value_binary[0]>               1          1    Covered              
        bin <inter_values[0],value_binary[0]>              18          1    Covered              
        bin <inter_values[1],value_binary[0]>              15          1    Covered              
        bin <inter_values[2],value_binary[0]>              15          1    Covered              
        bin <limit_values[0],value_binary[0]>               0          1    ZERO                 
        bin <limit_values[1],value_binary[0]>               0          1    ZERO                 

TOTAL COVERGROUP COVERAGE: 50.79%  COVERGROUP TYPES: 1
