VeresDenisa/Licenta/source/testbench/pack/UART_test_pack.sv

package UART_test_pack;
    import uvm_pkg::*;
    `include "uvm_macros.svh"
  
    import item_pack::*;
    import UART_sequence_pack::*;
  
    import UART_environment_pack::*;

    `define CLOCK 10
  
    `include "testbench/UART/test/test/UART_test.svh"
    `include "testbench/UART/test/test/UART_test_no_config.svh"
    `include "testbench/UART/test/test/UART_test_error.svh"
  endpackage : UART_test_pack
