VeresDenisa/Licenta/(commit log)

2024-06-21 Added sprint
    [CS_project_CS_implementation_mapvo.sdf, CS_project_CS_implementation_vho.sdf, CS_project_CS_implementation_vo.sdf]
2024-06-22 Update documentation and code anexes
    [coverage_CD_test_no_config.txt, coverage_UART_test_no_config.txt, coverage_VGA_test_no_config.txt]
2024-06-23 Moved from licenta_sistem_digital
    [CS_project_CS_implementation_mapvo.sdf, CS_project_CS_implementation_vho.sdf, CS_project_CS_implementation_vo.sdf, coverage_CD_test_no_config.txt, coverage_UART_test_no_config.txt, coverage_VGA_test_no_config.txt]
